inkubio/enjaksakavella/src/resources/arrow1.png

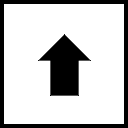
src/resources/arrow1.png
