inkubio/enjaksakavella/TODO.md

Electronics
===========
- Create 6V ref voltage without arduino before it boots
- Add emergency stop button
- Move electronics from breadboard to PCB

Arduino code
============
- Create arduino code for using serial connection to computer
- Add support for emergency stop button using interrupts

Python/Qt code
==============
- Re-design UI to be more user-friendly

Eye Tracker
-----------
- Make eye-finding non-blocking (move to seperate thread?)

Keyboard Controller
-------------------
- Add timeout to raise keypresses

Wheelchair controller
---------------------
- Improve BLE controlling code
- Add always-working emergency stop key (space bar?)
- Add serial controller for wheelchair

Other
=====
- Design holder for laptop
- Design encapsulation for the electronics
