inkubio/enjaksakavella/pcb/enjaksakavella.kicad_pcb

## KiCad design pcb/enjaksakavella.kicad_pcb (2022-03-25)

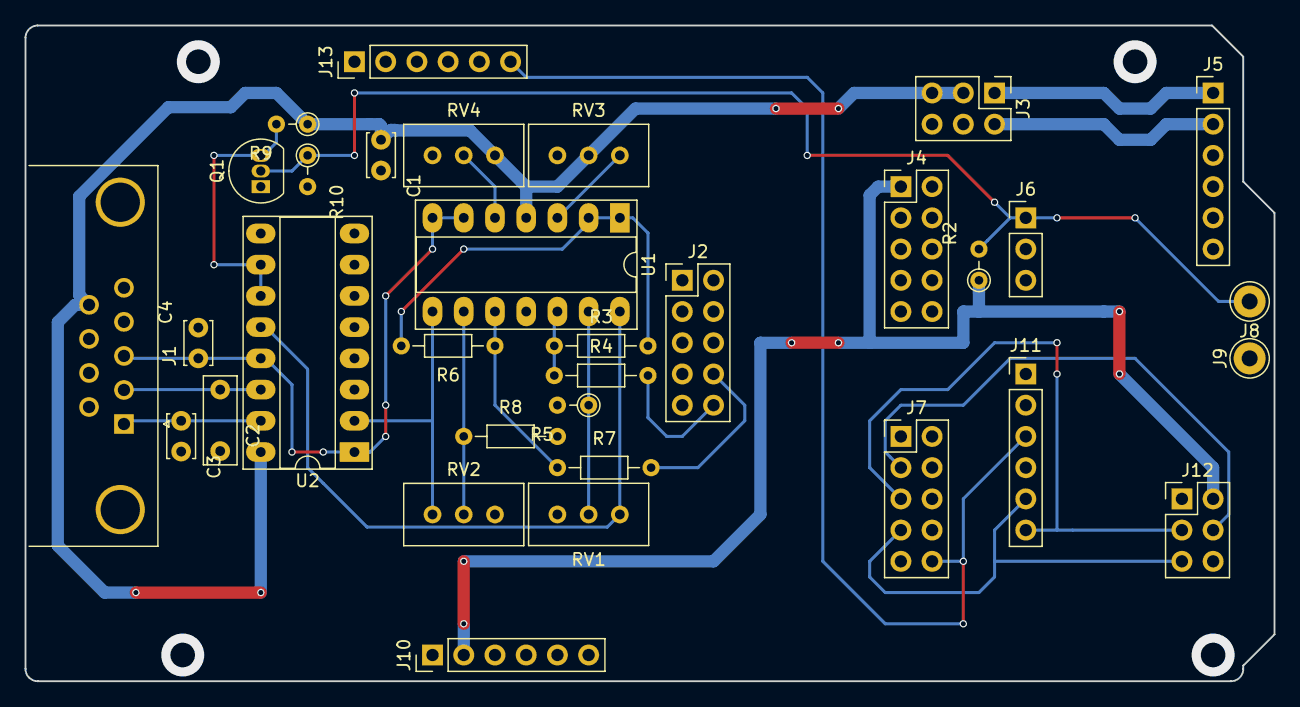
[picture p9: board enjaksakavella.kicad_pcb from above]

Board: 2 copper layers, 101.6 x 53.3 mm, 33 parts (0 on the bottom side), 25 nets.

Parts:
C1, C3, C4: 0.1u; C_Disc_D3.4mm_W2.1mm_P2.50mm
C2: 0.1u; C_Disc_D7.0mm_W2.5mm_P5.00mm
J1: DB9_Female; DSUB-9_Female_Horizontal_P2.77x2.84mm_EdgePinOffset4.94mm_H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
J2, J4, J7: Conn_02x05_Odd_Even; PinHeader_2x05_P2.54mm_Vertical
J3, J12: Conn_02x03_Odd_Even; PinHeader_2x03_P2.54mm_Vertical
J5, J10, J11, J13: Conn_01x06; PinHeader_1x06_P2.54mm_Vertical
J6: Conn_01x03; PinHeader_1x03_P2.54mm_Vertical
J8, J9: Conn_01x01; Pin_D1.3mm_L11.0mm
Q1: 2N7000; TO-92_Inline
R2, R9, R10: 10k; R_Axial_DIN0204_L3.6mm_D1.6mm_P2.54mm_Vertical
R3, R6: 47k; R_Axial_DIN0204_L3.6mm_D1.6mm_P7.62mm_Horizontal
R4, R7, R8: 39k; R_Axial_DIN0204_L3.6mm_D1.6mm_P7.62mm_Horizontal
R5: 39k; R_Axial_DIN0204_L3.6mm_D1.6mm_P2.54mm_Vertical
RV1, RV2, RV3, RV4: 50k; Potentiometer_Bourns_3296W_Vertical
U1: LM324; DIP-14_W7.62mm_Socket_LongPads
U2: 4053; DIP-16_W7.62mm_Socket_LongPads

Connections:
+3V3: J4.1, J10.2, J12.2, R2.1
+12V: C1.1, J1.9, J3.3, J3.5, R9.1, RV3.2, RV4.1, U1.4, U2.16
/DAC_O1: J2.10, R4.2
/DAC_O2: J2.8, R7.2
/DIR: C2.1, J1.2, U2.14
/J_DIR: RV1.3, U1.14, U2.12
/J_REF: C4.1, J1.3, U1.6, U1.7, U2.1, U2.13
/J_SPEED: RV2.3, U1.8, U2.2
/MISO: J7.5, J11.6, J12.3
/MOSI: J7.7, J11.5, J12.5
/OFFSET: R3.2, R6.2, U1.1, U1.2
/SCK: J7.3, J12.4
/SPEED: C3.1, J1.1, U2.15
/SS: J7.10, J11.3, J13.6
/STOP: J6.1, J8.1, Q1.2, R2.2, R10.1
GND: C1.2, C2.2, C3.2, C4.2, J1.4, J1.5, J1.6, J1.8, J3.4, J3.6, J4.6, J9.1, J10.4, J10.5, Q1.1, R5.2, R8.2, R10.2, RV3.3, RV4.3, U1.11, U2.6, U2.7, U2.8
unnamed: J3.1, J5.1
unnamed: J3.2, J5.2
unnamed: Q1.3, R9.2, U2.10, U2.11
unnamed: R3.1, R4.1, U1.12
unnamed: R5.1, RV1.2, U1.13
unnamed: R6.1, R7.1, U1.10
unnamed: R8.1, RV2.2, U1.9
unnamed: RV3.1, U1.3
unnamed: RV4.2, U1.5
