inkubio/enjaksakavella/src/bluez_dbus.py

"""Module to create BLE connection with DBus api."""

import time
import re
import threading

import pydbus
import gi.repository

from PySide2.QtCore import Slot, Signal, QObject

from util import ConnectionState

class BLEHelper(QObject):
    """Class to manage bluetooth connection to wheelchair."""
    connection_status = Signal(ConnectionState)

    def __init__(self, bt_adapter, bt_address, bt_uuid):
        super().__init__()
        self.stop_thread = False
        
        self.bt_adapter = bt_adapter
        self.bt_address = bt_address
        self.uuid = bt_uuid

        self.system_bus = pydbus.SystemBus()
        self.bluez = self.system_bus.get("org.bluez", "/")
        self.managed_objects = self.bluez.GetManagedObjects()
        self.dbus_base = "/org/bluez"

        self.dbus_adapter = self.dbus_base + "/" + self.bt_adapter
        self.hci0 = self.system_bus.get("org.bluez", self.dbus_adapter)

        # Get device object later when it has been found.
        self.dbus_device = self.dbus_adapter + "/dev_" \
            + self.bt_address.replace(":", "_")
        self.device = None

        # Find characteristic and get its dbus object later when connected
        self.dbus_characteristic = None
        self.characteristic = None

        self.dev_pattern = re.compile(self.dbus_adapter + "/dev_*")
        self.bt_devices = list(
            filter(
                self.dev_pattern.match,
                self.managed_objects.keys()
            ))

        self.connected = ConnectionState.DISCONNECTED

        self.cmd_thread = None

    def __del__(self):
        """Disconnect wheelchair when closing program.

        TODO: Delete extra dbus objects, too?
        """
        #self.bt_disconnect()
        #self._clear_dbus()

    def _get_characteristic_by_uuid(self):
        """Get BLE characteristic's DBus location."""
        uuid = self.uuid.lower()
        while True:
            self.managed_objects = self.bluez.GetManagedObjects()
            for key in self.managed_objects:
                if key.startswith(self.dbus_device):
                    dbus_object = self.system_bus.get("org.bluez", key)
                    try:
                        if dbus_object.UUID == uuid:
                            return key
                    except AttributeError as err:
                        test_str = ("'<CompositeObject>' "
                                    "object has no attribute 'UUID'")
                        if str(err) == test_str:
                            pass
                        else:
                            raise

    def _clear_dbus(self):
        """Clear saved Bluetooth connection to Arduino from operating system
        
        Use this to test establishing connection for the first time without
        restarting computer.
        """

        for key in self.managed_objects:
            if key.startswith(self.dbus_device):
                self.hci0.RemoveDevice(key)
                # Removing the top level DBus item removes the others too.
                break

    def _set_device(self):
        """Set DBus address for wheelchair's BLE device."""
        self.dbus_device = self.dbus_adapter \
            + "/dev_" \
            + self.bt_address.replace(":", "_")
        self.device = self.system_bus.get("org.bluez", self.dbus_device)

    def _set_characteristic(self):
        """Set DBus address for wheelchair's BLE characteristic."""
        self.dbus_characteristic = self._get_characteristic_by_uuid()
        self.characteristic = self.system_bus.get(
            "org.bluez",
            self.dbus_characteristic)

    @Slot()
    def bt_connect(self):
        """Establish connection with wheelchair.
        
        TODO: Explore ConnectProfile(string uuid) instead of Connect()
        """
        self.connected = ConnectionState.CONNECTING
        self.connection_status.emit(self.connected)
        if self._find_wheelchair():
            # If the application is closed before the wheelchair can be found
            self.connected = ConnectionState.DISCONNECTED
            return
        self._set_device()
        if self._connect_wheelchair():
            # If the application is closed while connecting
            self.connected = ConnectionState.DISCONNECTED
            return
        self.connected = ConnectionState.CONNECTED
        self._set_characteristic()
        self.connection_status.emit(self.connected)

    @Slot()
    def bt_disconnect(self):
        """Disconnect wheelchair."""
        if self.device:
            self.device.Disconnect()
        self.connected = ConnectionState.DISCONNECTED
        self.connection_status.emit(self.connected)

    def _find_wheelchair(self):
        """Search for wheelchair with BLE scan."""
        while not self.stop_thread and self.dbus_device not in self.bt_devices:
            try:
                self.hci0.StartDiscovery()
            except gi.repository.GLib.GError as err:
                error_text = ("g-io-error-quark: "
                              "GDBus.Error:org.bluez.Error.InProgress: "
                              "Operation already in progress (36)")
                if str(err) == error_text:
                    pass
                else:
                    raise
            time.sleep(1)
            #self.hci0.StopDiscovery()
            self.managed_objects = self.bluez.GetManagedObjects()
            self.bt_devices = list(
                filter(
                    self.dev_pattern.match,
                    self.managed_objects.keys()
                ))

        return self.stop_thread

    def _connect_wheelchair(self):
        """Establish bt connection with wheelchair.

        TODO: Improve exception handling. Currently only ignores them.
        """
        while not self.stop_thread:
            try:
                self.device.Connect()
                break
            except gi.repository.GLib.Error as err:
                err_timeout = ("g-io-error-quark: "
                               "GDBus.Error:org.bluez.Error.Failed: "
                               "Software caused connection abort (36)")
                err_connect_again = ("g-io-error-quark: "
                                     "GDBus.Error:org.bluez.Error.Failed: "
                                     "Operation already in progress (36)")
                if str(err) == err_timeout:
                    pass
                elif str(err) == err_connect_again:
                    pass
                else:
                    raise

        return self.stop_thread

    @Slot()
    def write_characteristic(self, cmd):
        """Write movement command to wheelchair.

        TODO: Improve exception handling.
        Errors to handle:
        If connection is broken (try to reconnect or do what?):
            g-io-error-quark: GDBus.Error:org.bluez.Error.Failed: \
                Not connected (36)
        """
        if self.connected != ConnectionState.CONNECTED:
            return
        try:
            if self.cmd_thread == None or not self.cmd_thread.is_alive():
                self.cmd_thread = threading.Thread(target=self.characteristic.WriteValue, args=[cmd, {}])
                self.cmd_thread.start()
        except gi.repository.GLib.Error as err:
            err_connection_broken = ("g-io-error-quark: "
                                     "GDBus.Error:org.bluez.Error.Failed: "
                                     "Not connected (36)")
            if str(err) == err_connection_broken:
                # What should we do here? try to reconnect?
                print("Connection broken while trying to write to device.")
                print("Reconnecting...")
                self.bt_connect()
            else:
                raise
