inkubio/enjaksakavella/(commit log)

2020-02-18 Added initial PCB schematics
    [Mega_Shield_enjaksa.brd, Mega_Shield_enjaksa.sch]
2020-02-19 Updated documentation to reflect current system
2020-04-10 Fix crash when quitting program
    [bluez_dbus.py, wheelchair_bt.py]
2020-04-21 Change EDA software (and file format) from EAGLE to KiCad
    [Mega_Shield_enjaksa.brd, Mega_Shield_enjaksa.sch, enjaksakavella.kicad_pcb, enjaksakavella.sch]
2022-03-16 Prevent infinite loop if closing app while connecting with BLE
    [bluez_dbus.py, wheelchair_bt.py]
2022-03-25 Update pcb files to new KiCad version
    [enjaksakavella.kicad_pcb, enjaksakavella.kicad_sch]
2022-03-25 Add accelerometer glasses controller
